simonwex/faceshield/images/chlorine_solution_math.jpg

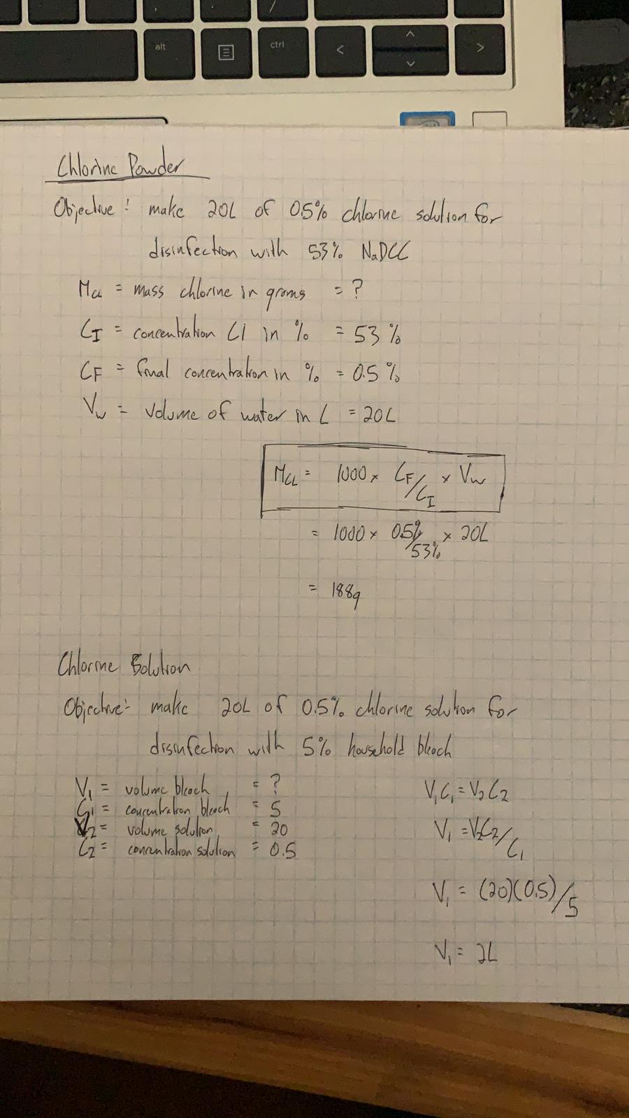
images/chlorine_solution_math.jpg
