simonwex/faceshield/README.md

# faceshield
Face shield personal protective equipment (PPE)

The goal of this project is to provide a cleanable, reusable face sheild for Covid response using materials that are readily available.
