simonwex/faceshield/prusa/covid19_headband_rc1.stl

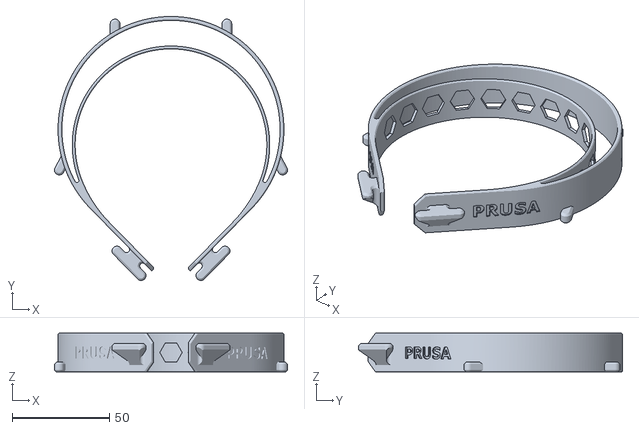
[picture p4: CAD file, 2020-03-21]
prusa/covid19_headband_rc1.stl
119.7 x 135.6 x 20.0
