simonwex/faceshield/source/Visor_Frame_NORTH_AMERICA_LETTER_vsteve.STL

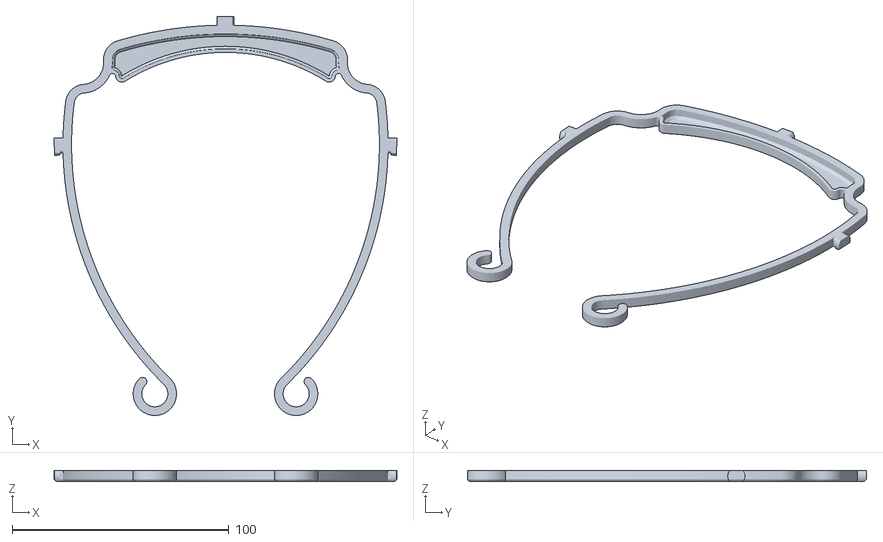
[picture p5: CAD file, 2020-03-25]
source/Visor_Frame_NORTH_AMERICA_LETTER_vsteve.STL
158.1 x 184.1 x 5.00
