simonwex/faceshield/Visor_Frame_3D_Print_Thin_Rest_Sans_Web.STL

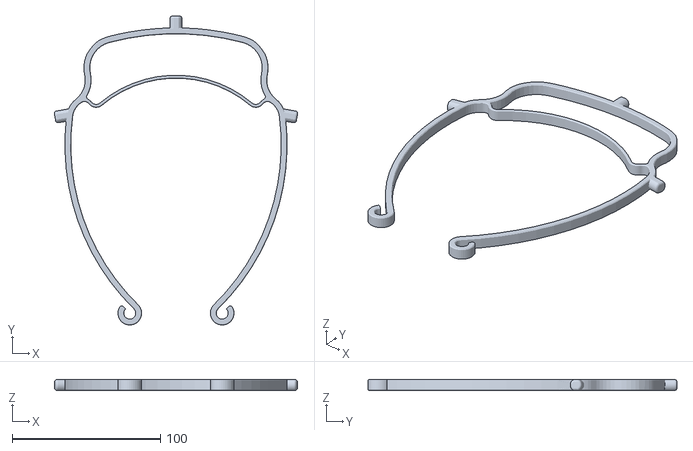
[picture p6: CAD file, 2020-03-27]
Visor_Frame_3D_Print_Thin_Rest_Sans_Web.STL
164.3 x 208.6 x 7.20
