simonwex/faceshield/prusa/bottom_reinforcement.stl

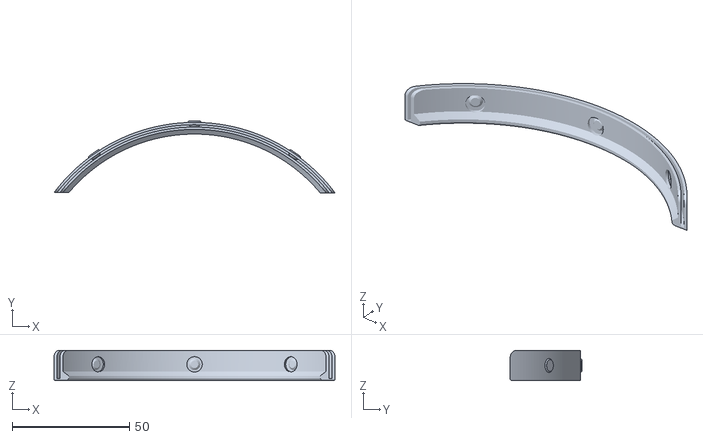
[picture p7: CAD file, 2020-03-21]
prusa/bottom_reinforcement.stl
120.1 x 30.6 x 13.0
