simonwex/faceshield/source/covid19_headband_sans_octagons_hooks.STL

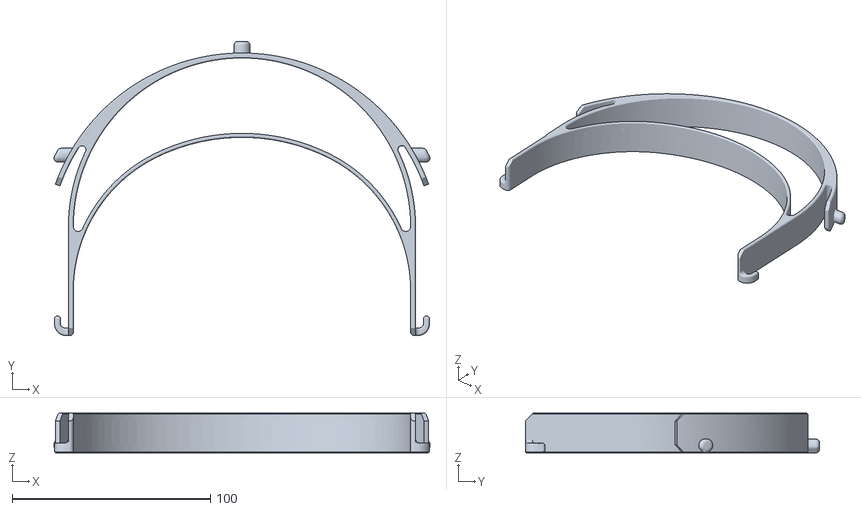
[picture p8: CAD file, 2020-03-24]
source/covid19_headband_sans_octagons_hooks.STL
189.5 x 148.4 x 20.0
