simonwex/faceshield/Visor_Frame_3D_Print.STL

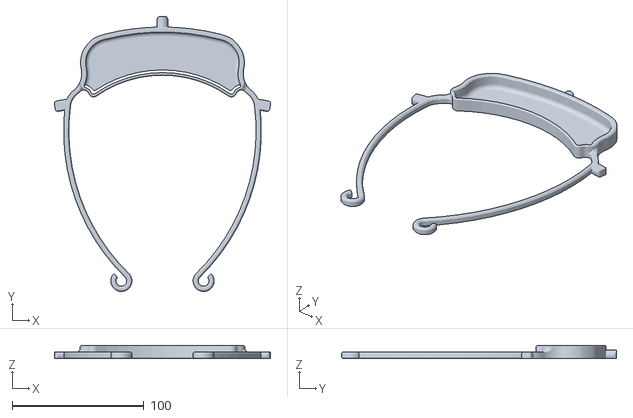
[picture p9: CAD file, 2020-03-26]
Visor_Frame_3D_Print.STL
164.1 x 208.6 x 10.0
