simonwex/faceshield/prusa/covid19_headband_rc2.stl

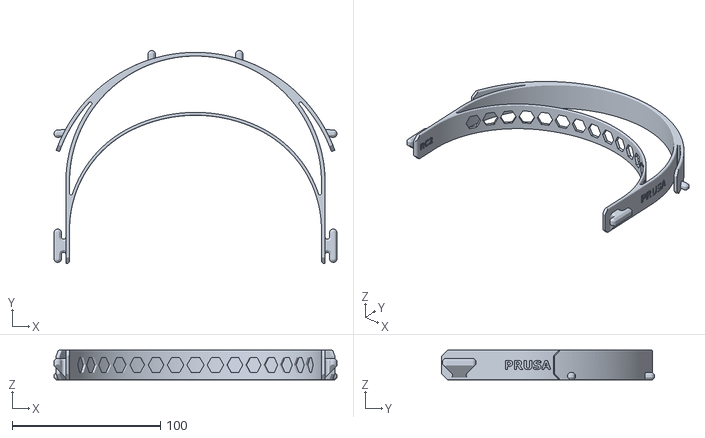
[picture p10: CAD file, 2020-03-21]
prusa/covid19_headband_rc2.stl
191.0 x 143.8 x 20.0
