simonwex/faceshield/source/covid19_headband.STL

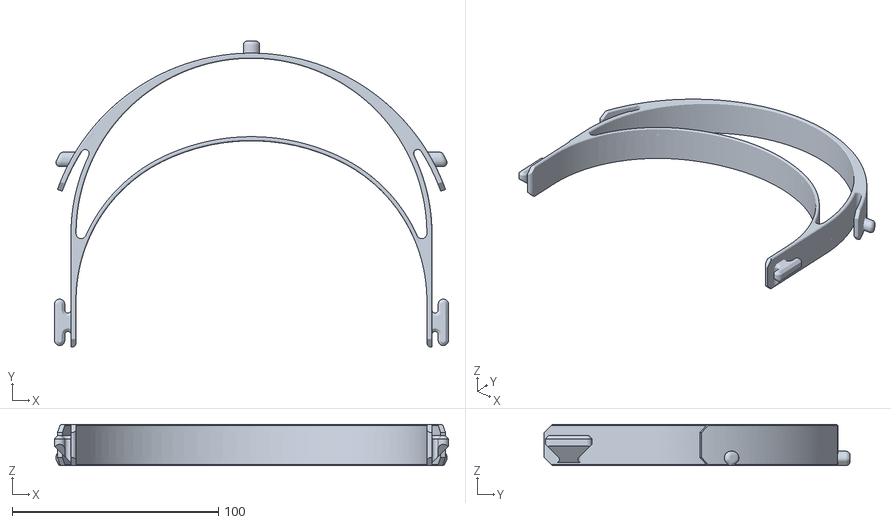
[picture p11: CAD file, 2020-03-24]
source/covid19_headband.STL
191.0 x 148.4 x 20.0
