simonwex/faceshield/Visor_Frame_CNC.DXF

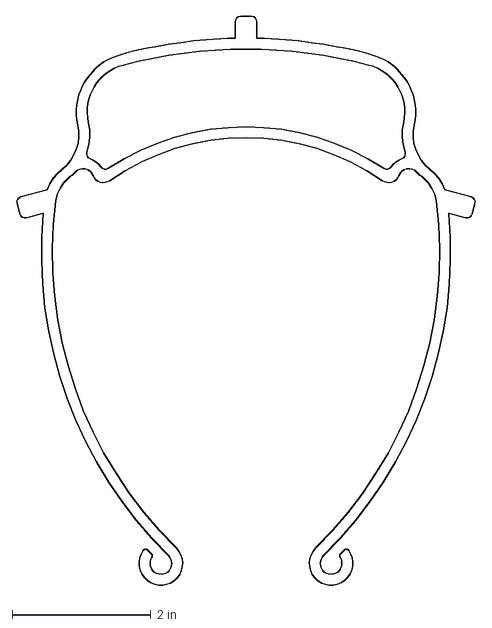
[picture p12: CAD file, 2020-03-26]
Visor_Frame_CNC.DXF
6.63 x 8.25 in
