simonwex/faceshield/prusa/shield_final.dxf

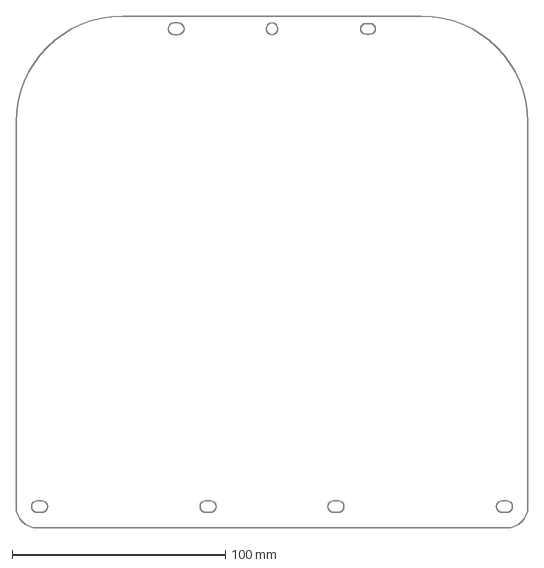
[picture p13: CAD file, 2020-03-21]
prusa/shield_final.dxf
240.0 x 240.0 mm
