simonwex/faceshield/Visor_Frame_3D_Print_sans_web.STL

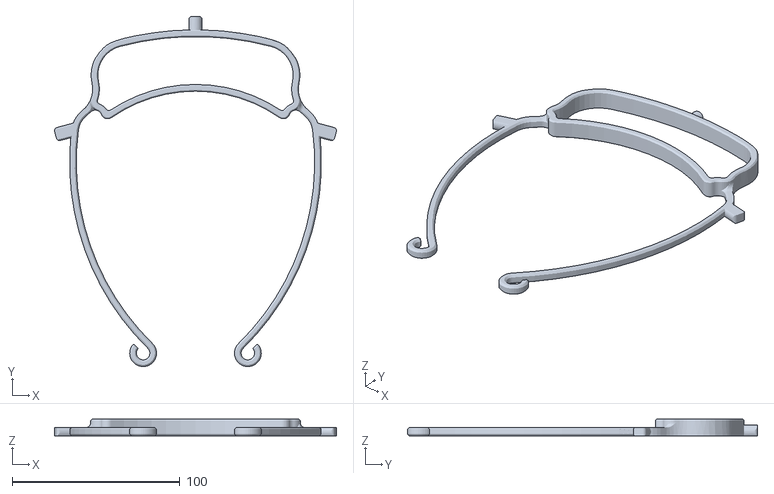
[picture p14: CAD file, 2020-03-26]
Visor_Frame_3D_Print_sans_web.STL
168.0 x 208.6 x 10.0
