simonwex/faceshield/Visor_Frame_3D_Print_Short.STL

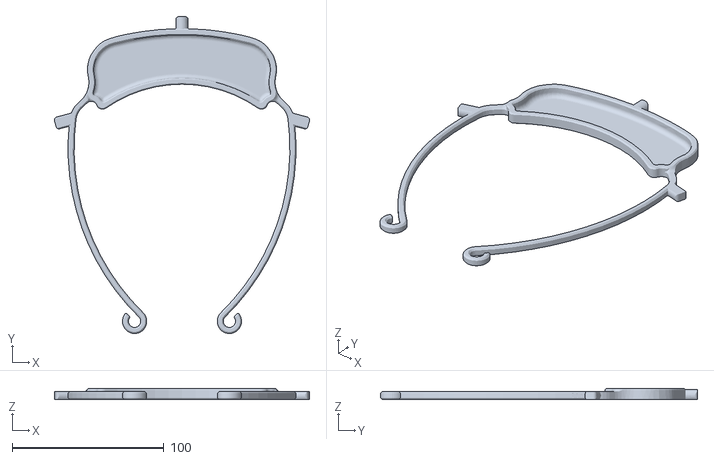
[picture p16: CAD file, 2020-03-26]
Visor_Frame_3D_Print_Short.STL
168.0 x 208.6 x 7.00
