simonwex/faceshield/prusa/shield_longer_version.stp

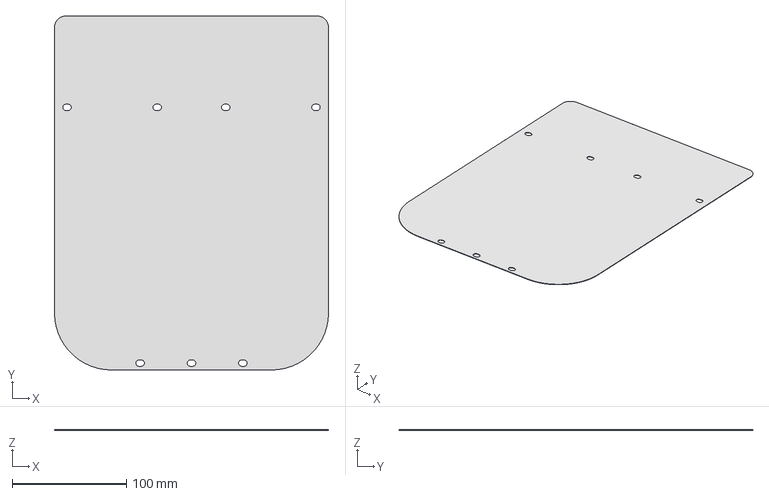
[picture p17: CAD file, 2020-03-21]
prusa/shield_longer_version.stp
240.0 x 310.0 x 0.5 mm
