simonwex/faceshield/(list of files, cad)

Other CAD files:
source/Visor_Frame_3D_Print.STL
source/Visor_Frame_3D_Print_Short.STL
source/Visor_Frame_3D_Print_Short_sans_web.STL
source/Visor_Frame_3D_Print_sans_web.STL
source/Visor_Frame_CNC.DXF
