simonwex/faceshield/(threads)

Thread 1 (2020-03-20):

Call Judy's designs

simonwex, 2020-03-20:
* [x] Elastic for straps (70cm per mask)
 * [ ] Neoprene
 * [x] cyanoacrylate

simonwex, 2020-03-20:
Judy has lots of elastic. Going to get some and see about alternate materials for removable padding.

simonwex, 2020-03-23:
Picked it up

Closed 2020-03-23.

Thread 2 (2020-03-20):

Call business center

simonwex, 2020-03-20:
25cm x 20cm x 0.125mm clear plastic sheet

simonwex, 2020-03-23:
Have A4 clear plastic sheet from business centre.

They also have this they're willing to donate:
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

Otherwise can get 11 1/4 x 8 3/4 with rounded corners in 9mil (0.2mm)

simonwex, 2020-03-23:
I think that 1.5mil is too thin

Closed 2020-03-23.

Thread 5 (2020-03-23):

Source 0.020 clear PETG

simonwex, 2020-03-23:

simonwex, 2020-03-23:
Plasticworld.ca
Talking to: James
416-630-6745

20 sheets @ $20 a sheet
$80 shipping

$586 including tax and shipping

simonwex, 2020-03-23:
https://www.johnstonplastics.com/edmonton/
780-465-0431
Talking to Ryan

$22.60
0-10

$19 per sheet
11 - 49

simonwex, 2020-03-23:
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

Ordered a box of GBC00158. I think this'll work and be a very easy thing to use.

whomisi, 2020-03-24:
Good work Simon, is this something your CNC could cut ? Or worst case, I guess you could CNC a template or two

revzimmer, 2020-03-24:
Signs ink laser would be able to cut it I bet

whomisi, 2020-03-24:
yeah but it's pretty small, it's a Legend Helix: 24" x 18" (610 x 457 mm)

revzimmer, 2020-03-24:
Cut a bunch at once??

Thread 6 (2020-03-23):

Validate prototype with SMG

simonwex, 2020-03-23:
Get feedback from local docs and ready a prototype for manufacturing.

simonwex, 2020-03-23:
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

Feedback:
> Works like a damn. I can't fog it up even if I breathe hard on the clear plastic when it is on.

> Looking closely I can see the grooves in the plastic from the printing. Grooves can't be wiped. That being said, we'll figure out a bath cleaning.

> It is both actually. Most of the time our heads will be bent downward when wearing so can't be long. I would say it is good for myself and I am average height.
> Rigidity is fine.
> It could be slightly more transparent.

> I would work on ditching the bottom part. Less is better when it comes to infection control. I just took it off. Works just fine without. We're wearing gowns that will protect form stabbing when it is on.

simonwex, 2020-03-23:
> Yes. Any sharp angles are a concern for infection control.

> If forced to push it through infection control I know that the 90 degree angles will be much more accepted than the sharp angles currently present.

revzimmer, 2020-03-23:
What size is that plastic shield?

whomisi, 2020-03-23:
If they're going to be bathing them, then what is stopping them bathing the ones they have already instead of throwing them out each day?

HarHarrison, 2020-03-23:
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
I believe these are the style being used currently, obviously can't be disinfected.

whomisi, 2020-03-23:
Ok, in Salmon Arm I am told that have this style, and the standalone (similar to what we're looking at printing) style
