simonwex/faceshield/(commit log)

2020-03-21 Adding prusa files
    [bottom_reinforcement.stl, covid19-shield.3mf, covid19_headband_rc1.stl, covid19_headband_rc2.stl, shield_final.dxf, shield_longer_version.stp]
2020-03-24 Removing old designs and license
    [buckle.stl, faceshieldx1.3mf, faceshieldx2.3mf, headpiece.stl]
2020-03-24 Updating 1.0
    [covid19_headband_sans_octagons_v1.1.STL, covid19_headband_sans_octagons_v1.STL]
2020-03-24 Renaming stl
    [covid19_headband.STL]
2020-03-26 Add files via upload
    25 03 2020
    [Visor_Frame_3D_Print.STL, Visor_Frame_3D_Print_Short.STL, Visor_Frame_3D_Print_Short_sans_web.STL, Visor_Frame_3D_Print_sans_web.STL, Visor_Frame_CNC.DXF]
2020-03-26 Add files via upload
    Added fillet to step between low and high sections
    [Visor_Frame_3D_Print.STL, Visor_Frame_3D_Print_Short.STL, Visor_Frame_3D_Print_Short_sans_web.STL, Visor_Frame_3D_Print_sans_web.STL]
2020-03-26 Nubs tipped back
    [Visor_Frame_3D_Print.STL, Visor_Frame_3D_Print_Short.STL, Visor_Frame_3D_Print_Short_sans_web.STL, Visor_Frame_3D_Print_sans_web.STL, Visor_Frame_CNC.DXF]
2020-03-26 Add files via upload
    Disconnected rest from web and made rest thinner
    [Visor_Frame_3D_Print.STL]
2020-03-26 Add files via upload
    Adjusted Nub Tension
    [Visor_Frame_3D_Print.STL]
2020-03-27 Add files via upload
    Thinner forehead rest, thicker overall, stackable, faster, better, stronger
    [Visor_Frame_3D_Print_Thin_Rest_Sans_Web.STL]
